N-Pulse/Transradial-Prosthesis-CTRL-HW/README.md

# Transradial Prosthesis Control Board

This work is licensed under a <a rel="license" href="https://creativecommons.org/licenses/by/4.0/">Creative Commons Attribution 4.0 International License</a>.
