N-Pulse/Transradial-Prosthesis-CTRL-HW/NPulse_v4/image-1.png

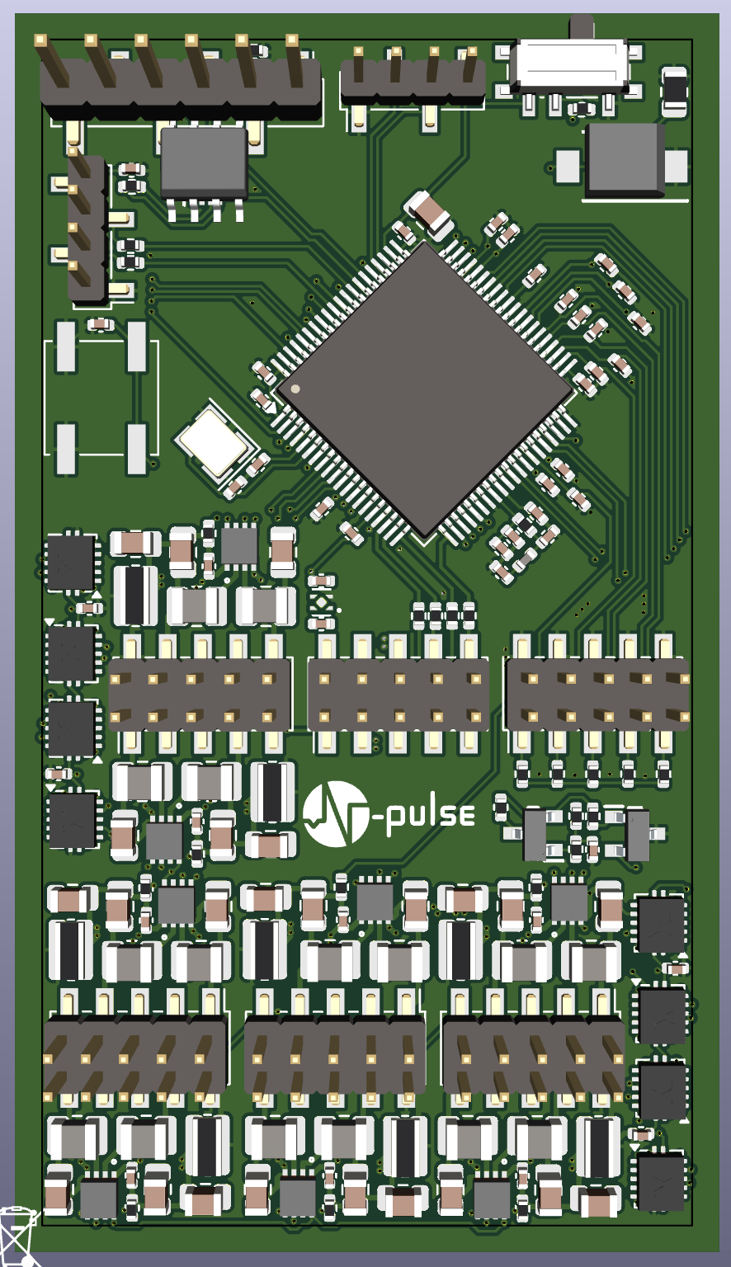
NPulse_v4/image-1.png
