N-Pulse/Transradial-Prosthesis-CTRL-HW/Report/figures/architecture.png

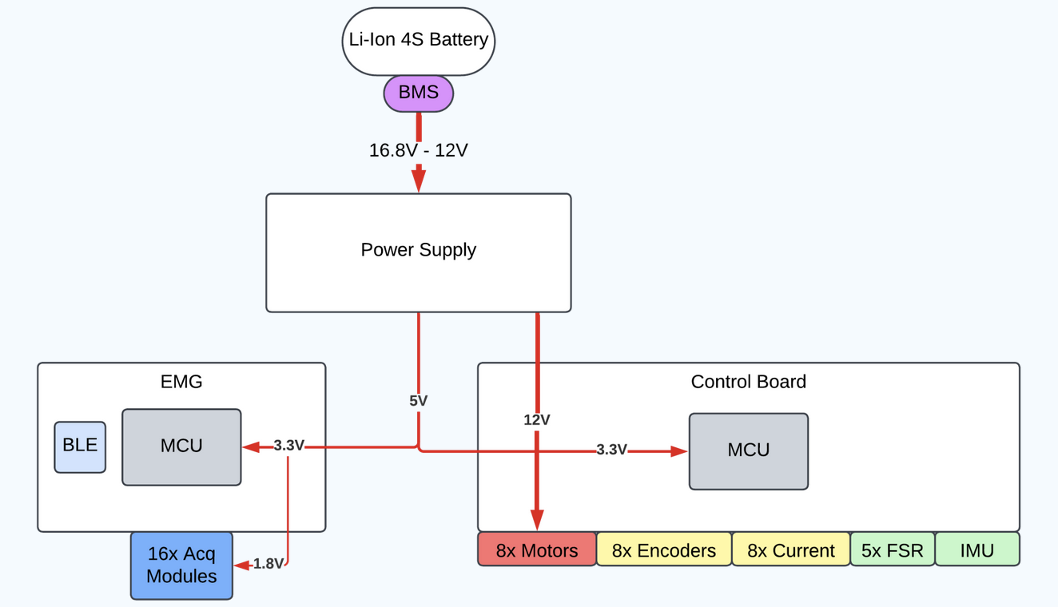
Report/figures/architecture.png
