N-Pulse/Transradial-Prosthesis-CTRL-HW/components/DRV8220DSGR/DSG0008A.stp

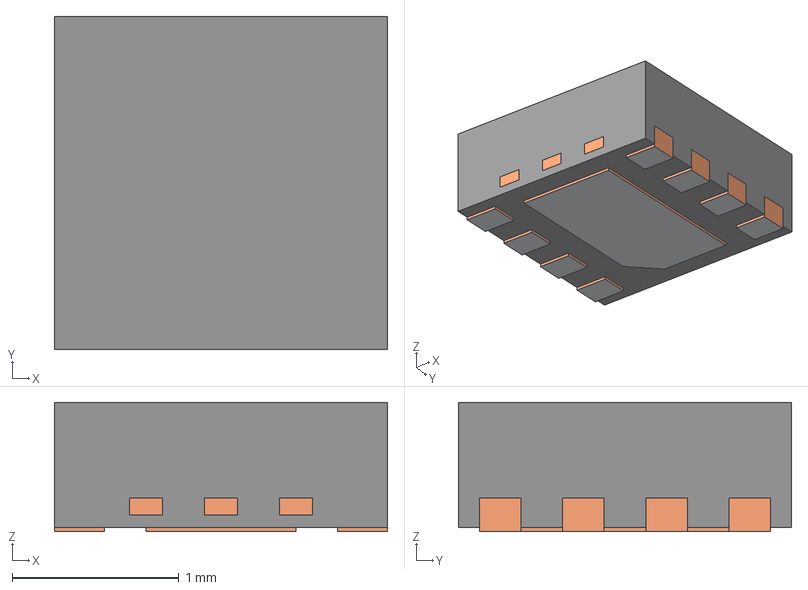
[picture p3: CAD file, 2025-02-24]
components/DRV8220DSGR/DSG0008A.stp
2.00 x 2.00 x 0.775 mm
BODY-SON
FRAME-DSG0008A
PIN1-ID
