N-Pulse/Transradial-Prosthesis-CTRL-HW/components/LIB_74HC14BQ-Q100,115/74HC14BQ-Q100,115/3D/74HC14BQ-Q100,115.stp

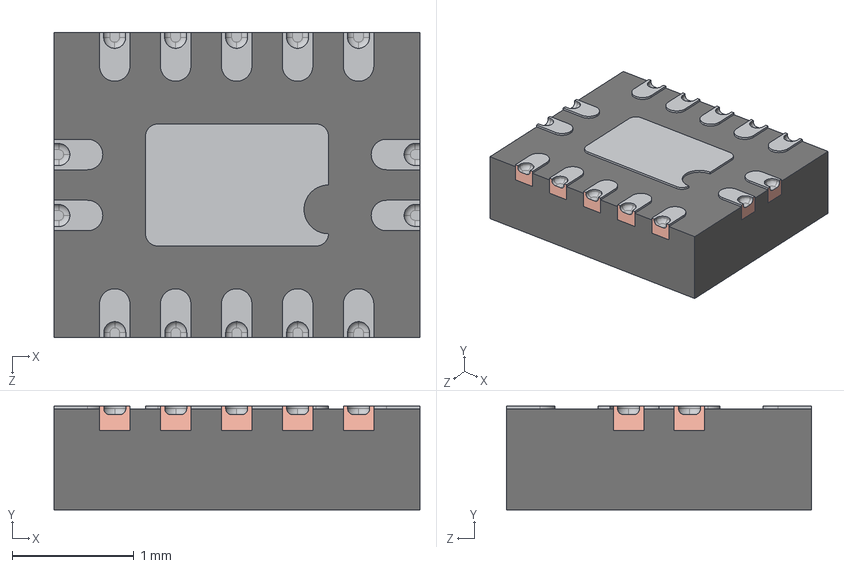
[picture p4: CAD file, 2025-02-24]
components/LIB_74HC14BQ-Q100,115/74HC14BQ-Q100,115/3D/74HC14BQ-Q100,115.stp
3.00 x 0.85 x 2.50 mm
SOT762 Body
SOT762 Heatsink
SOT762 Lead x 14
