N-Pulse/Transradial-Prosthesis-CTRL-HW/components/LIB_BSS138/BSS138/3D/BSS138.step

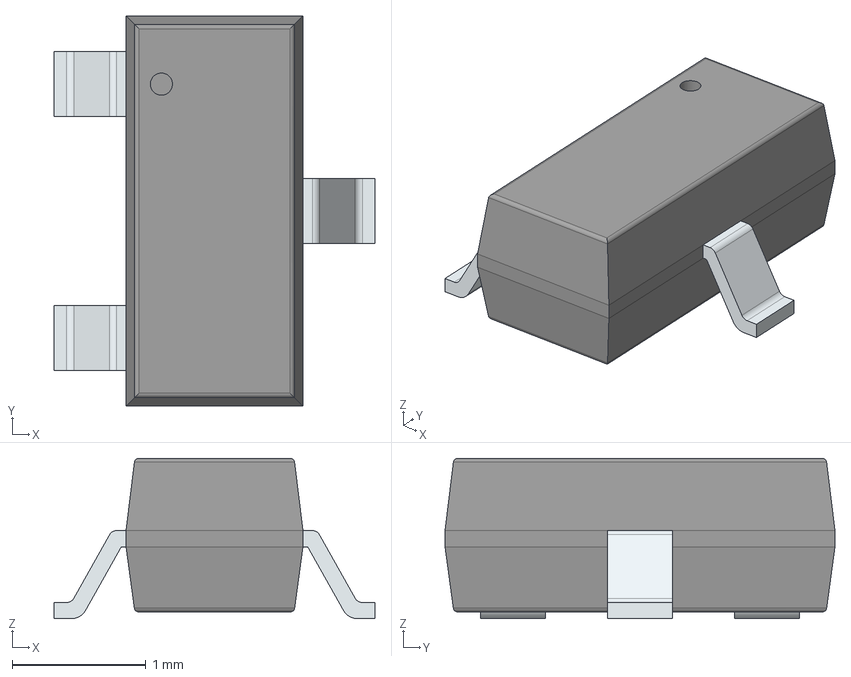
[picture p5: CAD file, 2025-02-24]
components/LIB_BSS138/BSS138/3D/BSS138.step
2.40 x 2.92 x 1.20 mm
PinsArrayL
FilletPinR
