N-Pulse/Transradial-Prosthesis-CTRL-HW/components/LIB_LQH5BPB100MT0L/LQH5BPB100MT0L/3D/LQH5BPB100MT0L.step

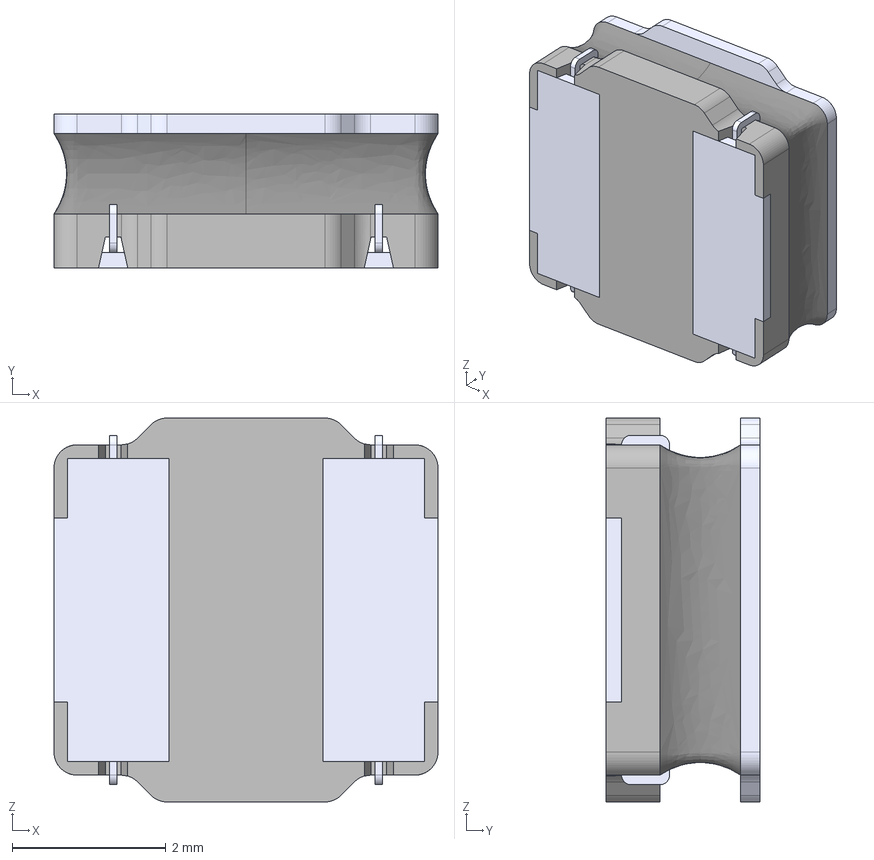
[picture p6: CAD file, 2025-02-24]
components/LIB_LQH5BPB100MT0L/LQH5BPB100MT0L/3D/LQH5BPB100MT0L.step
5.00 x 2.00 x 5.00 mm
