N-Pulse/Transradial-Prosthesis-CTRL-HW/components/LIB_QSB34CGR/QSB34CGR/3D/QSB34CGR.step

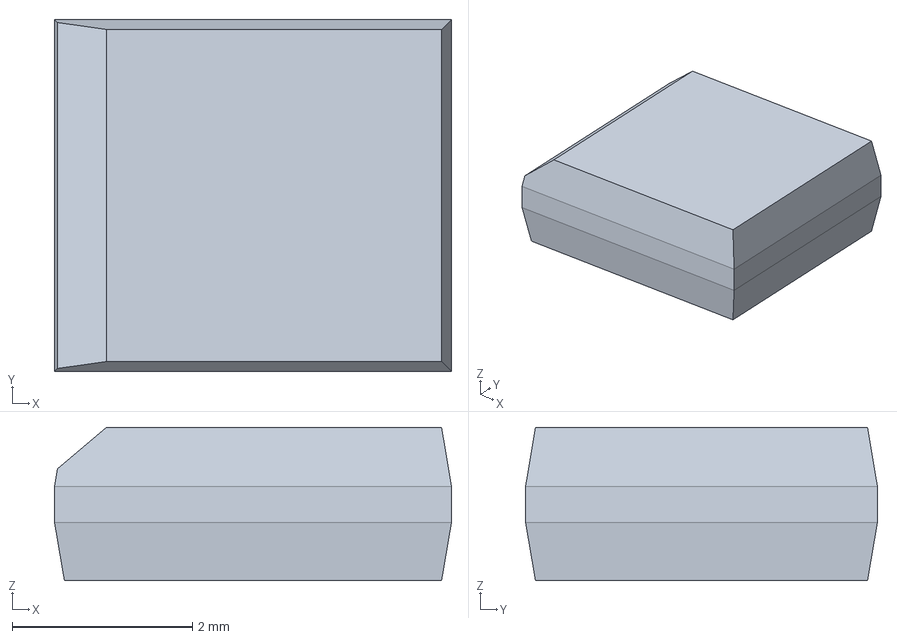
[picture p7: CAD file, 2025-02-24]
components/LIB_QSB34CGR/QSB34CGR/3D/QSB34CGR.step
4.40 x 3.90 x 1.70 mm
