N-Pulse/Transradial-Prosthesis-CTRL-HW/components/LIB_STM32G484MET6/STM32G484MET6/3D/STM32G484MET6.stp

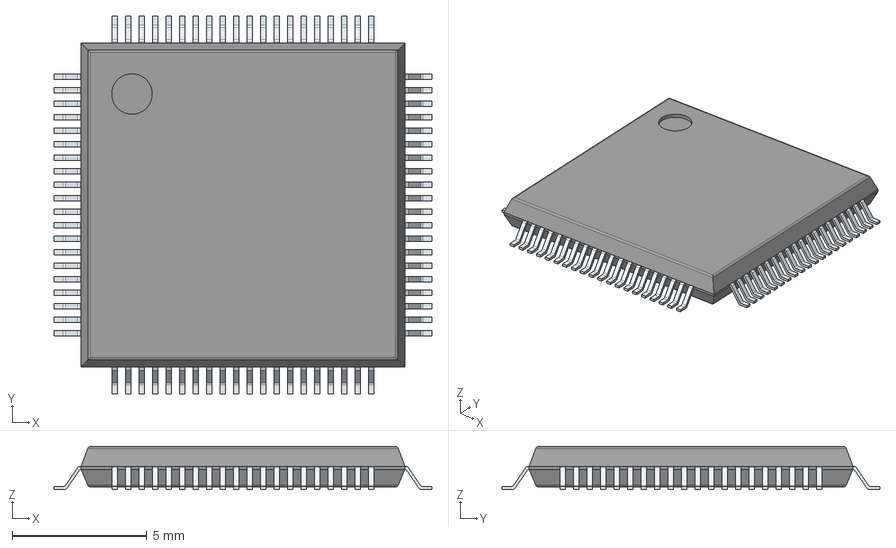
[picture p8: CAD file, 2025-02-24]
components/LIB_STM32G484MET6/STM32G484MET6/3D/STM32G484MET6.stp
14.0 x 14.0 x 1.60 mm
PinsArrayLR
PinsArrayTB
