N-Pulse/Transradial-Prosthesis-CTRL-HW/components/LIB_TL3305BF100QG/TL3305BF100QG/3D/TL3305BF100QG.step

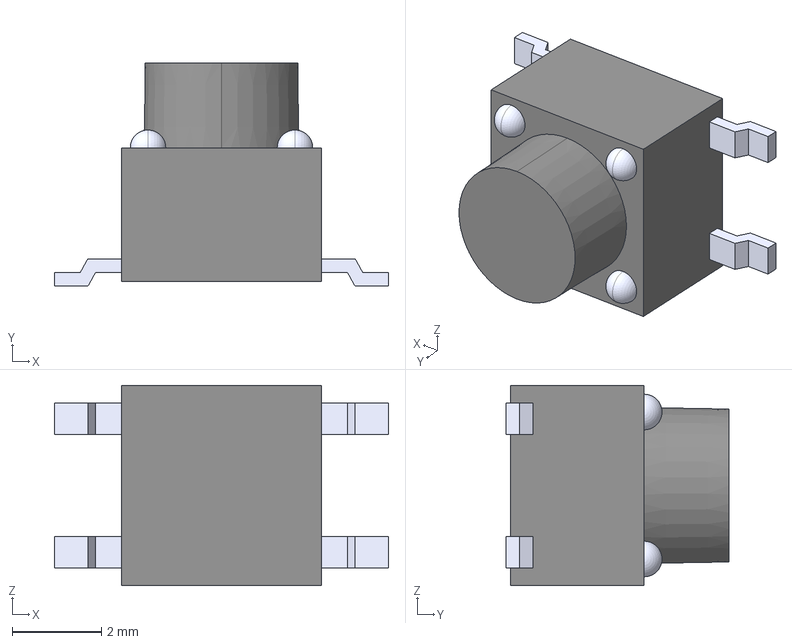
[picture p9: CAD file, 2025-02-26]
components/LIB_TL3305BF100QG/TL3305BF100QG/3D/TL3305BF100QG.step
7.50 x 5.00 x 4.50 mm
