N-Pulse/Transradial-Prosthesis-CTRL-HW/components/LIB_TXU0202DCUR 2/TXU0202DCUR/3D/TXU0202DCUR.step

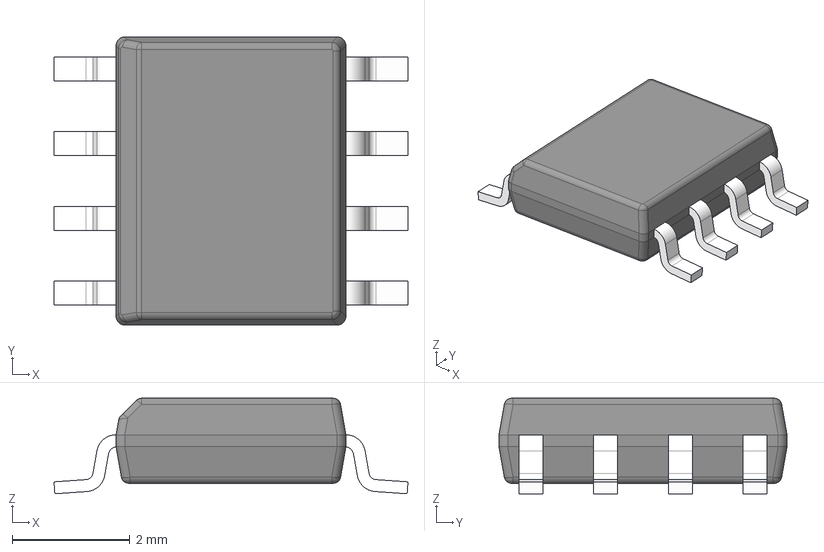
[picture p10: CAD file, 2025-02-24]
components/LIB_TXU0202DCUR 2/TXU0202DCUR/3D/TXU0202DCUR.step
6.02 x 4.90 x 1.63 mm
BODY-SO
LEAD-D0008A x 8
