N-Pulse/Transradial-Prosthesis-CTRL-HW/components/ul_TXU0202DCUR/DCU0008A.stp

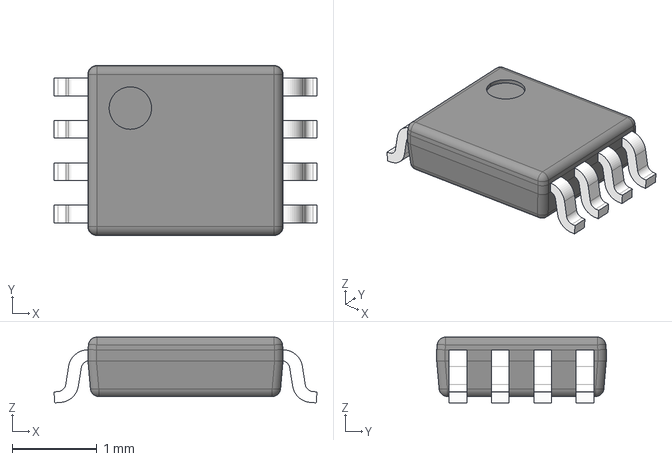
[picture p11: CAD file, 2025-02-26]
components/ul_TXU0202DCUR/DCU0008A.stp
3.10 x 2.00 x 0.775 mm
BODY-VSSOP
LEAD-VSSOP x 8
