N-Pulse/Transradial-Prosthesis-CTRL-HW/NPulse_v4/connecteur/connecteur.step

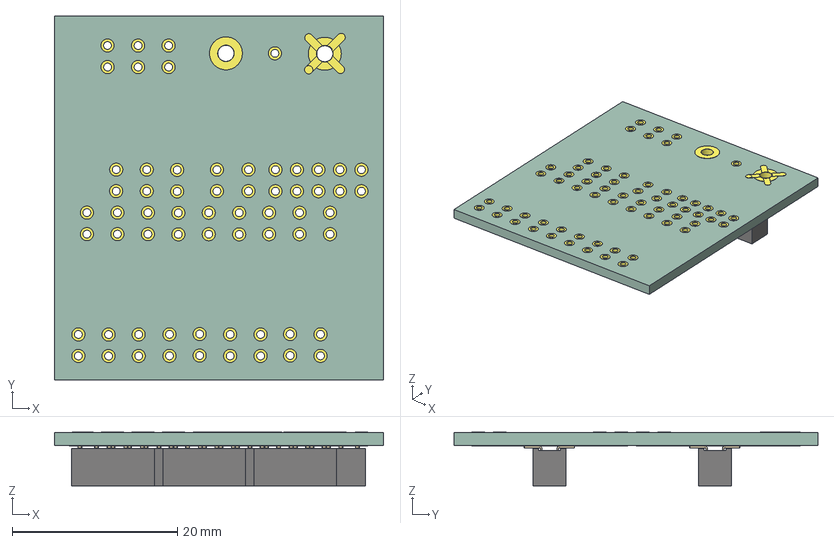
[picture p12: CAD file, 2025-02-24]
NPulse_v4/connecteur/connecteur.step
39.8 x 44.0 x 6.49 mm
PinSocket_2x05_P200mm_Vertical_SMD x 6
connecteur_track_1
connecteur_track_2
connecteur_track_3
connecteur_track_4
connecteur_track_5
connecteur_track_6
connecteur_track_7
connecteur_track_8
connecteur_track_9
connecteur_track_10
connecteur_track_11
connecteur_track_12
connecteur_track_13
connecteur_track_14
connecteur_track_15
connecteur_track_16
connecteur_track_17
connecteur_track_18
connecteur_track_19
connecteur_track_20
connecteur_track_21
connecteur_track_22
connecteur_track_23
connecteur_track_24
connecteur_track_25
connecteur_track_26
connecteur_track_27
connecteur_track_28
connecteur_track_29
connecteur_track_30
connecteur_track_31
connecteur_track_32
connecteur_track_33
connecteur_track_34
connecteur_track_35
connecteur_track_36
connecteur_track_37
connecteur_track_38
connecteur_track_39
connecteur_track_40
connecteur_track_41
connecteur_track_42
connecteur_track_43
connecteur_track_44
connecteur_track_45
connecteur_track_46
connecteur_track_47
connecteur_track_48
connecteur_track_49
connecteur_track_50
connecteur_track_51
connecteur_track_52
connecteur_track_53
connecteur_track_54
connecteur_track_55
connecteur_track_56
connecteur_track_57
connecteur_track_58
connecteur_track_59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
