N-Pulse/Transradial-Prosthesis-CTRL-HW/(list of files, cad)

Other CAD files:
components/LIB_74LVC02ABQ,115/74LVC02ABQ,115/3D/74LVC02ABQ,115.step
components/LIB_74LVC02ABQ,115/74LVC02ABQ,115/KiCad/74LVC02ABQ_115.step
components/LIB_BSS84/BSS84/3D/BSS84.step
components/LIB_BSS84/BSS84/KiCad/BSS84.step
components/LIB_DRV8220DSGR/DRV8220DSGR/3D/DRV8220DSGR.step
components/LIB_1725737/1725737/3D/1725737.step
components/LIB_1725737/1725737/3D/1725737.stp
components/LIB_1725737/1725737/Allegro/1725737.psm
components/LIB_1725737/1725737/DEHDL/1725737/chips/chips.prt
components/LIB_1725737/1725737/KiCad/1725737.step
components/LIB_1725737/1725737/KiCad/1725737.stp
components/LIB_1725753/1725753/3D/1725753.step
components/LIB_1725753/1725753/3D/1725753.stp
components/LIB_1725753/1725753/Allegro/1725753.psm
components/LIB_1725753/1725753/DEHDL/1725753/chips/chips.prt
components/LIB_1725753/1725753/KiCad/1725753.step
components/LIB_1725753/1725753/KiCad/1725753.stp
components/LIB_1985221/1985221/3D/1985221.step
components/LIB_1985221/1985221/3D/1985221.stp
components/LIB_1985221/1985221/DEHDL/1985221/chips/chips.prt
components/LIB_1985234/1985234/3D/1985234.step
components/LIB_1985234/1985234/3D/1985234.stp
components/LIB_1985234/1985234/DEHDL/1985234/chips/chips.prt
components/LIB_74HC14BQ-Q100,115/74HC14BQ-Q100,115/Allegro/74hc14bqq100115.psm
components/LIB_74HC14BQ-Q100,115/74HC14BQ-Q100,115/DEHDL/74hc14bq_q100_115/chips/chips.prt
components/LIB_74LVC02ABQ,115/74LVC02ABQ,115/Allegro/74lvc02abq115.psm
components/LIB_74LVC02ABQ,115/74LVC02ABQ,115/DEHDL/74lvc02abq_115/chips/chips.prt
components/LIB_BSS138/BSS138/3D/BSS138.stp
components/LIB_BSS138/BSS138/Allegro/sot95p240x120-3n.psm
components/LIB_BSS138/BSS138/DEHDL/bss138/chips/chips.prt
components/LIB_BSS138/BSS138/KiCad/BSS138.stp
components/LIB_BSS84/BSS84/3D/BSS84.stp
components/LIB_BSS84/BSS84/Allegro/sot95p240x120-3n.psm
components/LIB_BSS84/BSS84/DEHDL/bss84/chips/chips.prt
components/LIB_BSS84/BSS84/KiCad/BSS84.stp
components/LIB_DRV8220DSGR/DRV8220DSGR/Allegro/son50p200x200x80-9n.psm
components/LIB_DRV8220DSGR/DRV8220DSGR/DEHDL/drv8220dsgr/chips/chips.prt
components/LIB_LQH5BPB100MT0L/LQH5BPB100MT0L/3D/LQH5BPB100MT0L.stp
components/LIB_LQH5BPB100MT0L/LQH5BPB100MT0L/Allegro/lqh5bpb100mt0l.psm
components/LIB_LQH5BPB100MT0L/LQH5BPB100MT0L/DEHDL/lqh5bpb100mt0l/chips/chips.prt
components/LIB_LQH5BPB100MT0L/LQH5BPB100MT0L/KiCad/LQH5BPB100MT0L.stp
components/LIB_QSB34CGR/QSB34CGR/3D/QSB34CGR.stp
components/LIB_QSB34CGR/QSB34CGR/Allegro/sod6439x180n.psm
components/LIB_QSB34CGR/QSB34CGR/DEHDL/qsb34cgr/chips/chips.prt
components/LIB_QSB34CGR/QSB34CGR/KiCad/QSB34CGR.stp
components/LIB_STM32G484MET6/STM32G484MET6/Allegro/qfp50p1400x1400x160-80n.psm
components/LIB_STM32G484MET6/STM32G484MET6/DEHDL/stm32g484met6/chips/chips.prt
components/LIB_TL3305BF100QG/TL3305BF100QG/3D/TL3305BF100QG.stp
components/LIB_TL3305BF100QG/TL3305BF100QG/Allegro/tl3305bf160qg.psm
components/LIB_TL3305BF100QG/TL3305BF100QG/DEHDL/tl3305bf100qg/chips/chips.prt
components/LIB_TXU0202DCUR 2/TXU0202DCUR/3D/TXU0202DCUR.stp
components/LIB_TXU0202DCUR 2/TXU0202DCUR/Allegro/sop50p310x90-8n.psm
components/LIB_TXU0202DCUR 2/TXU0202DCUR/DEHDL/txu0202dcur/chips/chips.prt
