N-Pulse/Transradial-Prosthesis-CTRL-HW/(list of files, drawings)

Other design files:
components/LIB_74HC14BQ-Q100,115/74HC14BQ-Q100,115/Altium/74HC14BQ-Q100_115.SchLib
components/LIB_74HC14BQ-Q100,115/74HC14BQ-Q100,115/Altium/74HC14BQQ100115.PcbLib
components/LIB_74LVC02ABQ,115/74LVC02ABQ,115/Altium/74LVC02ABQ115.PcbLib
components/LIB_74LVC02ABQ,115/74LVC02ABQ,115/Altium/74LVC02ABQ_115.SchLib
components/LIB_1725737/1725737/Altium/1725737.PcbLib
components/LIB_1725737/1725737/Altium/1725737.SchLib
components/LIB_1725753/1725753/Altium/1725753.PcbLib
components/LIB_1725753/1725753/Altium/1725753.SchLib
components/LIB_1985221/1985221/Altium/1985221.PcbLib
components/LIB_1985221/1985221/Altium/1985221.SchLib
components/LIB_1985234/1985234/Altium/1985234.PcbLib
components/LIB_1985234/1985234/Altium/1985234.SchLib
components/LIB_BSS84/BSS84/Altium/BSS84.SchLib
components/LIB_BSS84/BSS84/Altium/SOT95P240X120-3N.PcbLib
components/LIB_BSS138/BSS138/Altium/BSS138.SchLib
components/LIB_BSS138/BSS138/Altium/SOT95P240X120-3N.PcbLib
components/LIB_DRV8220DSGR/DRV8220DSGR/Altium/DRV8220DSGR.SchLib
components/LIB_DRV8220DSGR/DRV8220DSGR/Altium/SON50P200X200X80-9N.PcbLib
components/LIB_LQH5BPB100MT0L/LQH5BPB100MT0L/Altium/LQH5BPB100MT0L.PcbLib
components/LIB_LQH5BPB100MT0L/LQH5BPB100MT0L/Altium/LQH5BPB100MT0L.SchLib
components/LIB_QSB34CGR/QSB34CGR/Altium/QSB34CGR.SchLib
components/LIB_QSB34CGR/QSB34CGR/Altium/SOD6439X180N.PcbLib
components/LIB_STM32G484MET6/STM32G484MET6/Altium/QFP50P1400X1400X160-80N.PcbLib
components/LIB_STM32G484MET6/STM32G484MET6/Altium/STM32G484MET6.SchLib
components/LIB_TXU0202DCUR/TXU0202DCUR/Altium/SOP50P310X90-8N.PcbLib
components/LIB_TXU0202DCUR/TXU0202DCUR/Altium/TXU0202DCUR.SchLib
