N-Pulse/Transradial-Prosthesis-CTRL-HW/NPulse_v4/connecteur/connecteur.kicad_pcb

## KiCad design NPulse_v4/connecteur/connecteur.kicad_pcb (2025-03-10)

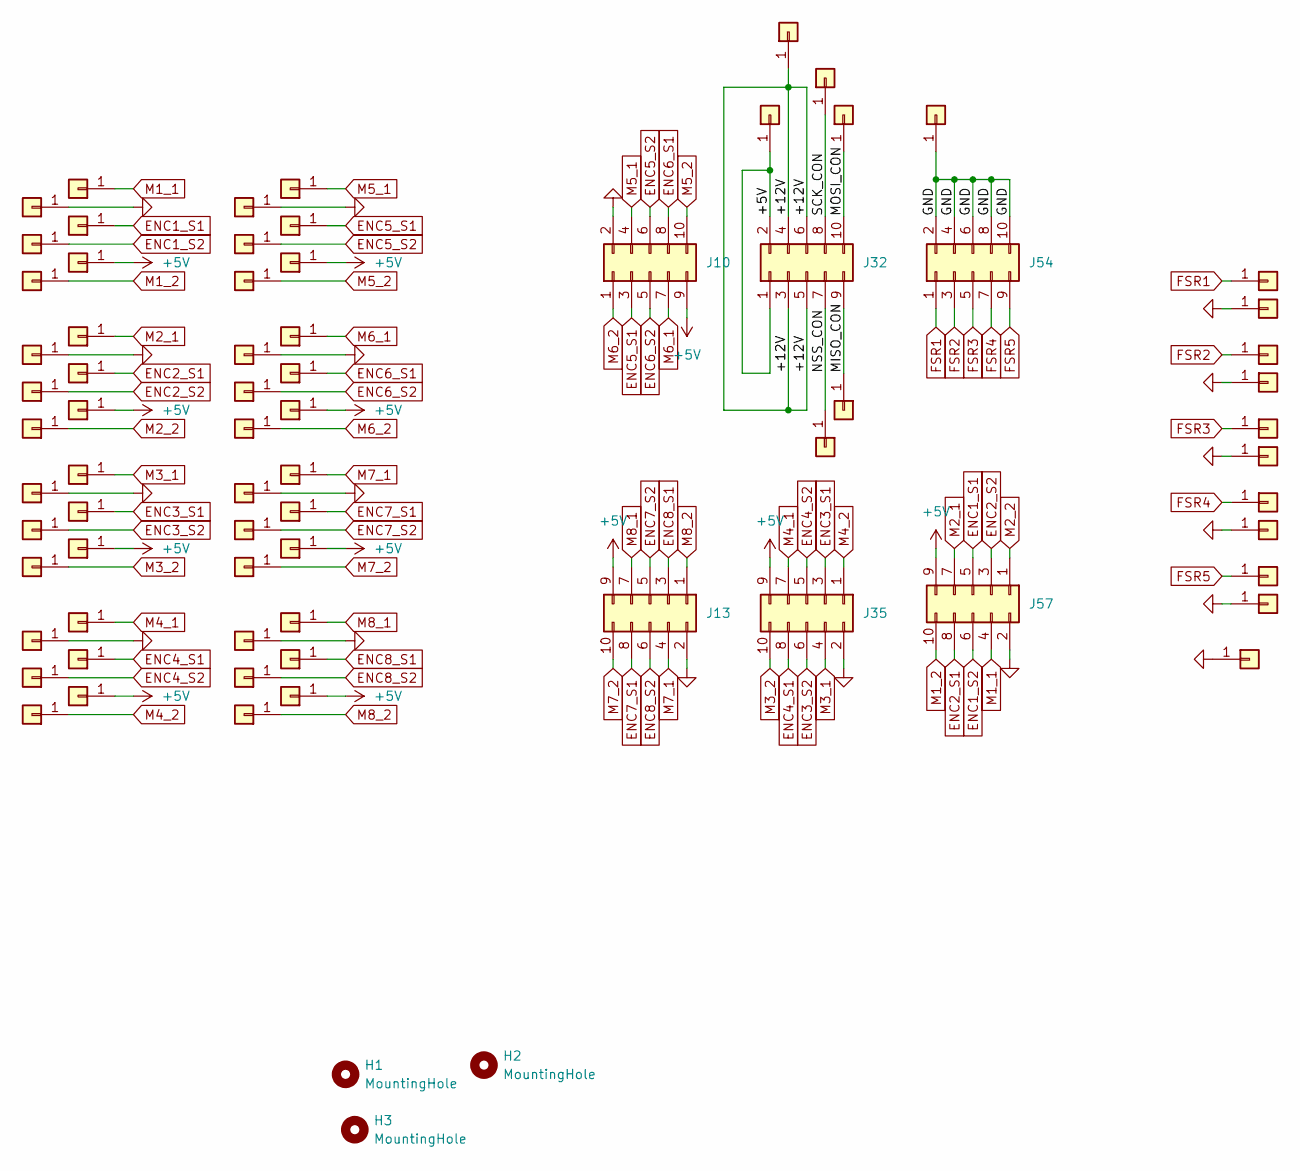
[picture p13: schematic connecteur.kicad_sch]

Parts:
H1, H2, H3: MountingHole; MountingHole_2.2mm_M2
J1, J2, J3, J4, J5, J6, J7, J8, J9, J11, J12, J14, J15, J16, J17, J18, J19, J20, J21, J22, J23, J25, J26, J27, J29, J30, J34, J36, J37, J38, J39, J40, J41, J42, J43, J44, J45, J46, J47, J48, J49, J50, J51, J52, J53, J55, J56, J58, J59, J60, J61, J62, J63, J64, J65, J66, J67, J68, J69, J70, J72, J73, J74, J75, J76, J77: Conn_01x01; SolderWire-0.1sqmm_1x01_D0.4mm_OD1mm
J10, J13, J32, J35, J54, J57: Conn_02x05_Odd_Even; PinSocket_2x05_P2.00mm_Vertical_SMD

Connections:
+5V: J6.1, J10.9, J13.9, J14.1, J20.1, J23.1, J30.1, J32.1, J32.2, J35.9, J44.1, J53.1, J57.9, J63.1, J70.1
/+12V: J27.1, J32.3, J32.4, J32.5, J32.6
/MISO_CON: J32.9, J42.1
/MOSI_CON: J32.10, J41.1
/NSS_CON: J32.7, J38.1
/SCK_CON: J32.8, J37.1
ENC1_S1: J4.1, J57.5
ENC1_S2: J3.1, J57.6
ENC2_S1: J12.1, J57.8
ENC2_S2: J8.1, J57.3
ENC3_S1: J19.1, J35.3
ENC3_S2: J16.1, J35.6
ENC4_S1: J29.1, J35.8
ENC4_S2: J22.1, J35.5
ENC5_S1: J10.3, J43.1
ENC5_S2: J10.6, J36.1
ENC6_S1: J10.8, J52.1
ENC6_S2: J10.5, J48.1
ENC7_S1: J13.8, J62.1
ENC7_S2: J13.5, J58.1
ENC8_S1: J13.3, J69.1
ENC8_S2: J13.6, J66.1
FSR1: J54.1, J72.1
FSR2: J46.1, J54.3
FSR3: J54.5, J55.1
FSR4: J54.7, J64.1
FSR5: J54.9, J75.1
GND: J2.1, J7.1, J10.2, J13.2, J15.1, J21.1, J34.1, J35.2, J45.1, J47.1, J50.1, J54.2, J54.4, J54.6, J54.8, J54.10, J56.1, J57.2, J60.1, J65.1, J73.1, J74.1, J76.1, J77.1
M1_1: J1.1, J57.4
M1_2: J5.1, J57.10
M2_1: J11.1, J57.7
M2_2: J9.1, J57.1
M3_1: J18.1, J35.4
M3_2: J17.1, J35.10
M4_1: J26.1, J35.7
M4_2: J25.1, J35.1
M5_1: J10.4, J40.1
M5_2: J10.10, J39.1
M6_1: J10.7, J51.1
M6_2: J10.1, J49.1
M7_1: J13.4, J61.1
M7_2: J13.10, J59.1
M8_1: J13.7, J68.1
M8_2: J13.1, J67.1

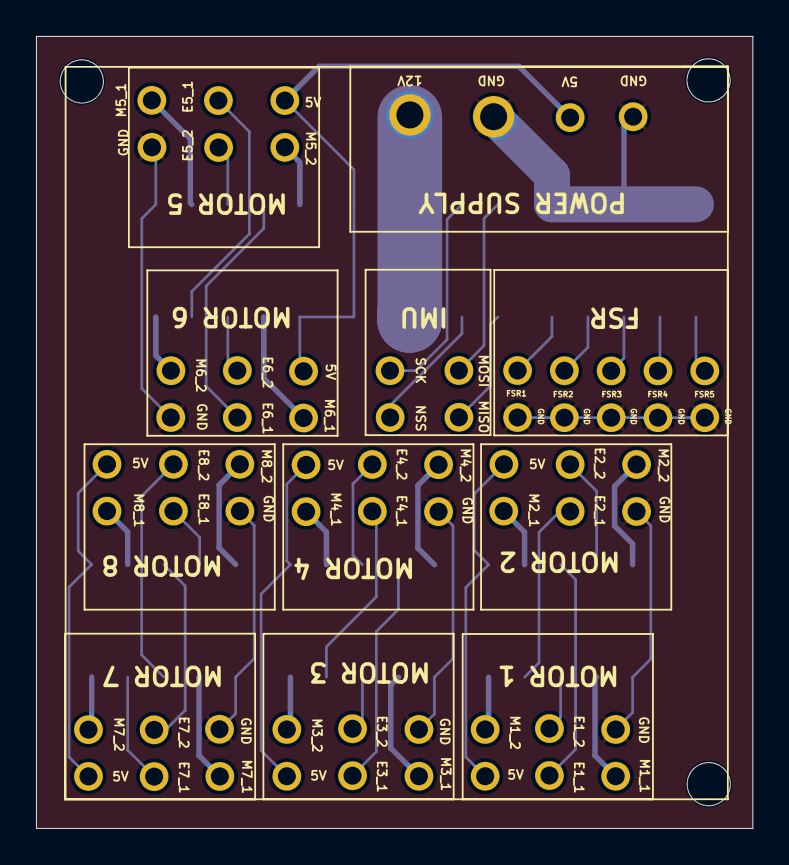
[picture p14: board connecteur.kicad_pcb from above]

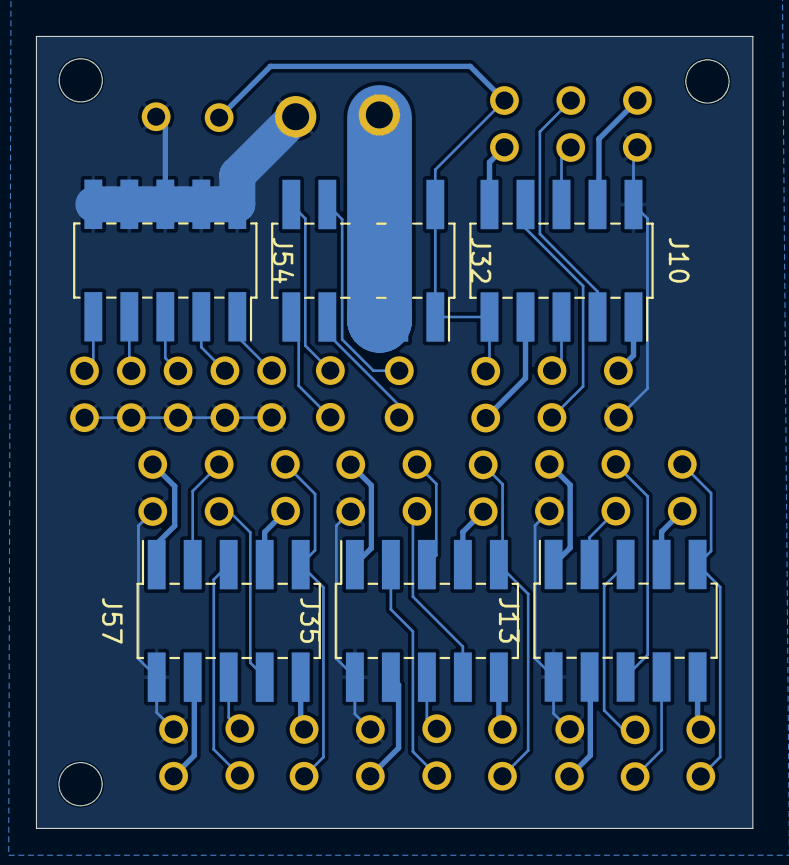
[picture p15: board connecteur.kicad_pcb from below]

Board: 4 copper layers, 39.8 x 44.0 mm, 75 parts (6 on the bottom side), 44 nets.
