N-Pulse/Transradial-Prosthesis-CTRL-HW/NPulse_v4/NPulse_v4.kicad_pcb

## KiCad design NPulse_v4/NPulse_v4.kicad_pcb (2025-03-10)

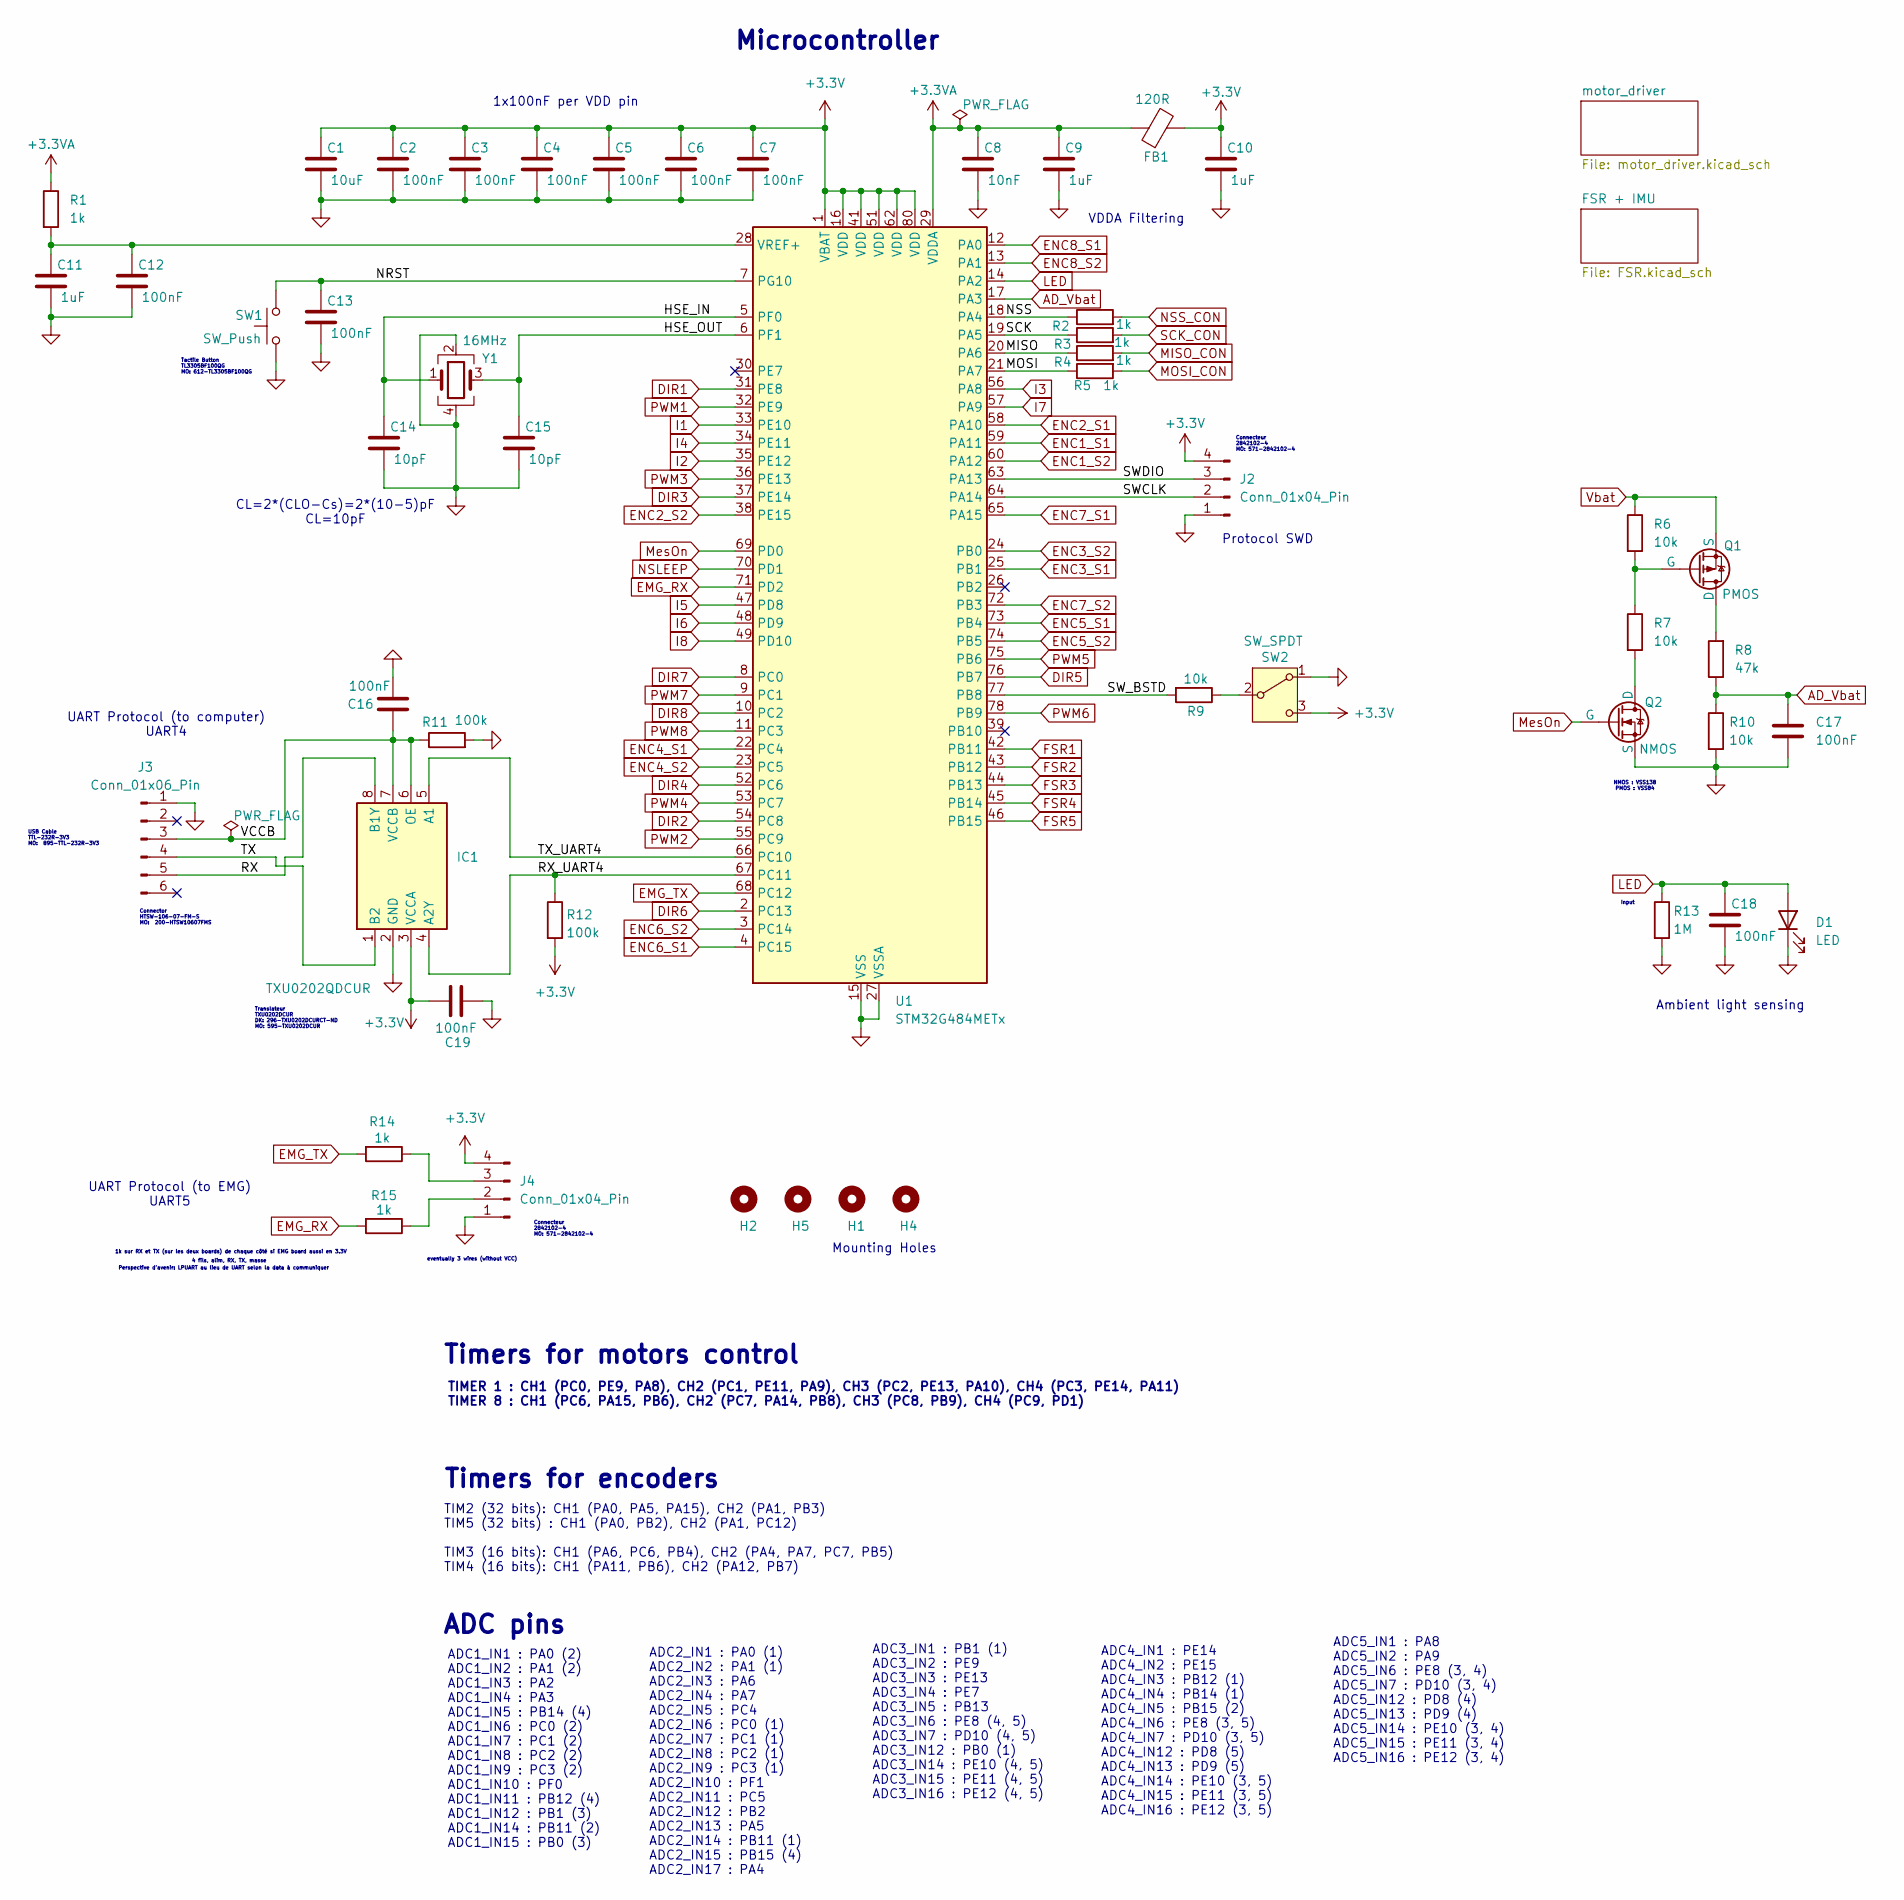
[picture p16: schematic NPulse_v4.kicad_sch]

Parts:
C1: 10uF; C_0805_2012Metric
C2, C3, C4, C5, C6, C7, C12, C13, C16, C17, C18, C19: 100nF; C_0402_1005Metric
C8: 10nF; C_0402_1005Metric
C9, C10, C11: 1uF; C_0402_1005Metric
C14, C15: 10pF; C_0402_1005Metric
D1: LED; SOD6439X180N
FB1: 120R; L_0402_1005Metric
H1, H2, H4, H5: MountingHole; MountingHole_2.2mm_M2
IC1: TXU0202QDCUR; SOP50P310X90-8N; Mouser Part Number 595-TXU0202QDCURQ1
J2, J4: Conn_01x04_Pin; PinHeader_1x04_P2.00mm_Vertical_SMD_Pin1Left
J3: Conn_01x06_Pin; PinHeader_1x06_P2.54mm_Vertical_SMD_Pin1Left
Q1: PMOS; SOT95P240X120-3N
Q2: NMOS; SOT95P240X120-3N
R1, R2, R3, R4, R5, R14, R15: 1k; R_0402_1005Metric
R6, R7, R9, R10: 10k; R_0402_1005Metric
R8: 47k; R_0402_1005Metric
R11, R12: 100k; R_0402_1005Metric
R13: 1M; R_0805_2012Metric
SW1: SW_Push; SW_SPST_TL3305B
SW2: SW_SPDT; SW_SPDT_PCM12
U1: STM32G484METx; LQFP-80_12x12mm_P0.5mm
Y1: 16MHz; Crystal_SMD_3225-4Pin_3.2x2.5mm

Connections:
+3.3V: C1.1, C2.1, C3.1, C4.1, C5.1, C6.1, C7.1, C10.1, C19.2, FB1.2, IC1.3 (VCCA), J2.4, J4.4, R12.2, SW2.3 (C), U1.1 (VBAT), U1.16 (VDD), U1.41 (VDD), U1.51 (VDD), U1.62 (VDD), U1.80 (VDD); also elsewhere on the board
+3.3VA: C8.1, C9.1, FB1.1, R1.1, U1.29 (VDDA)
/HSE_IN: C14.1, U1.5 (PF0), Y1.1
/HSE_OUT: C15.1, U1.6 (PF1), Y1.3
/MISO: R4.1, U1.20 (PA6)
/MOSI: R5.1, U1.21 (PA7)
/NRST: C13.1, SW1.1, U1.7 (PG10)
/NSS: R2.1, U1.18 (PA4)
/RX: IC1.8 (B1Y), J3.5
/RX_UART4: IC1.4 (A2Y), R12.1, U1.67 (PC11)
/SCK: R3.1, U1.19 (PA5)
/SWCLK: J2.2, U1.64 (PA14)
/SWDIO: J2.3, U1.63 (PA13)
/SW_BSTD: R9.2, U1.77 (PB8)
/TX: IC1.1 (B2), J3.4
/TX_UART4: IC1.5 (A1), U1.66 (PC10)
/VCCB: C16.2, IC1.6 (OE), IC1.7 (VCCB), J3.3, R11.1
AD_Vbat: C17.1, R8.1, R10.1, U1.17 (PA3)
DIR1: U1.31 (PE8); also elsewhere on the board
DIR2: U1.54 (PC8); also elsewhere on the board
DIR3: U1.37 (PE14); also elsewhere on the board
DIR4: U1.52 (PC6); also elsewhere on the board
DIR5: U1.76 (PB7); also elsewhere on the board
DIR6: U1.2 (PC13); also elsewhere on the board
DIR7: U1.8 (PC0); also elsewhere on the board
DIR8: U1.10 (PC2); also elsewhere on the board
EMG_RX: R15.2, U1.71 (PD2)
EMG_TX: R14.2, U1.68 (PC12)
ENC1_S1: U1.59 (PA11); also elsewhere on the board
ENC1_S2: U1.60 (PA12); also elsewhere on the board
ENC2_S1: U1.58 (PA10); also elsewhere on the board
ENC2_S2: U1.38 (PE15); also elsewhere on the board
ENC3_S1: U1.25 (PB1); also elsewhere on the board
ENC3_S2: U1.24 (PB0); also elsewhere on the board
ENC4_S1: U1.22 (PC4); also elsewhere on the board
ENC4_S2: U1.23 (PC5); also elsewhere on the board
ENC5_S1: U1.73 (PB4); also elsewhere on the board
ENC5_S2: U1.74 (PB5); also elsewhere on the board
ENC6_S1: U1.4 (PC15); also elsewhere on the board
ENC6_S2: U1.3 (PC14); also elsewhere on the board
ENC7_S1: U1.65 (PA15); also elsewhere on the board
ENC7_S2: U1.72 (PB3); also elsewhere on the board
ENC8_S1: U1.12 (PA0); also elsewhere on the board
ENC8_S2: U1.13 (PA1); also elsewhere on the board
FSR1: U1.42 (PB11); also elsewhere on the board
FSR2: U1.43 (PB12); also elsewhere on the board
FSR3: U1.44 (PB13); also elsewhere on the board
FSR4: U1.45 (PB14); also elsewhere on the board
FSR5: U1.46 (PB15); also elsewhere on the board
GND: C1.2, C2.2, C3.2, C4.2, C5.2, C6.2, C7.2, C8.2, C9.2, C10.2, C11.2, C12.2, C13.2, C14.2, C15.2, C16.1, C17.2, C18.2, C19.1, D1.1 (K), IC1.2 (GND), J2.1, J3.1, J4.1, Q2.3 (S), R10.2, R11.2, R13.2, SW1.2, SW2.1 (A), U1.15 (VSS), U1.27 (VSSA), U1.40 (VSS), U1.50 (VSS), U1.61 (VSS), U1.79 (VSS), Y1.2, Y1.4; also elsewhere on the board
I1: U1.33 (PE10); also elsewhere on the board
I2: U1.35 (PE12); also elsewhere on the board
I3: U1.56 (PA8); also elsewhere on the board
I4: U1.34 (PE11); also elsewhere on the board
I5: U1.47 (PD8); also elsewhere on the board
I6: U1.48 (PD9); also elsewhere on the board
I7: U1.57 (PA9); also elsewhere on the board
I8: U1.49 (PD10); also elsewhere on the board
LED: C18.1, D1.2 (A), R13.1, U1.14 (PA2)
MISO_CON: R4.2; also elsewhere on the board
MOSI_CON: R5.2; also elsewhere on the board
MesOn: Q2.2 (G), U1.69 (PD0)
NSLEEP: U1.70 (PD1); also elsewhere on the board
NSS_CON: R2.2; also elsewhere on the board
unnamed: J4.2, R15.1
unnamed: J4.3, R14.1
unnamed: Q1.1 (D), R8.2
unnamed: Q1.2 (G), R6.2, R7.1
unnamed: Q2.1 (D), R7.2
unnamed: R9.1, SW2.2 (B)
unnamed: C11.1, C12.1, R1.2, U1.28 (VREF+)
PWM1: U1.32 (PE9); also elsewhere on the board
PWM2: U1.55 (PC9); also elsewhere on the board
PWM3: U1.36 (PE13); also elsewhere on the board
PWM4: U1.53 (PC7); also elsewhere on the board
PWM5: U1.75 (PB6); also elsewhere on the board
PWM6: U1.78 (PB9); also elsewhere on the board
PWM7: U1.9 (PC1); also elsewhere on the board
PWM8: U1.11 (PC3); also elsewhere on the board
SCK_CON: R3.2; also elsewhere on the board
Vbat: Q1.3 (S), R6.1

Notes on the sheet:
1x100nF per VDD pin
NMOS : VSS138 PMOS : VSS84
1k sur RX et TX (sur les deux boards) de chaque côté si EMG board aussi en 3.3V
UART Protocol (to computer) UART4
ADC3_IN1 : PB1 (1) ADC3_IN2 : PE9 ADC3_IN3 : PE13 ADC3_IN4 : PE7 ADC3_IN5 : PB13 ADC3_IN6 : PE8 (4, 5) ADC3_IN7 : PD10 (4, 5) ADC3_IN12 : PB0 (1) ADC3_IN14 : PE10 (4, 5) ADC3_IN15 : PE11 (4, 5) ADC3_IN16 : PE12 (4, 5)
Mounting Holes
ADC2_IN1 : PA0 (1) ADC2_IN2 : PA1 (1) ADC2_IN3 : PA6 ADC2_IN4 : PA7 ADC2_IN5 : PC4 ADC2_IN6 : PC0 (1) ADC2_IN7 : PC1 (1) ADC2_IN8 : PC2 (1) ADC2_IN9 : PC3 (1) ADC2_IN10 : PF1 ADC2_IN11 : PC5 ADC2_IN12 : PB2 ADC2_IN13 : PA5 ADC2_IN14 : PB11 (1) ADC2_IN15 : PB15 (4) ADC2_IN17 : PA4
USB Cable TTL-232R-3V3 MO: 895-TTL-232R-3V3
Timers for motors control
ADC4_IN1 : PE14 ADC4_IN2 : PE15 ADC4_IN3 : PB12 (1) ADC4_IN4 : PB14 (1) ADC4_IN5 : PB15 (2) ADC4_IN6 : PE8 (3, 5) ADC4_IN7 : PD10 (3, 5) ADC4_IN12 : PD8 (5) ADC4_IN13 : PD9 (5) ADC4_IN14 : PE10 (3, 5) ADC4_IN15 : PE11 (3, 5) ADC4_IN16 : PE12 (3, 5)
Translateur TXU0202DCUR DK: 296-TXU0202DCURCT-ND MO: 595-TXU0202DCUR
TIM2 (32 bits): CH1 (PA0, PA5, PA15), CH2 (PA1, PB3) TIM5 (32 bits) : CH1 (PA0, PB2), CH2 (PA1, PC12) TIM3 (16 bits): CH1 (PA6, PC6, PB4), CH2 (PA4, PA7, PC7, PB5) TIM4 (16 bits): CH1 (PA11, PB6), CH2 (PA12, PB7)
VDDA Filtering
ADC1_IN1 : PA0 (2) ADC1_IN2 : PA1 (2) ADC1_IN3 : PA2 ADC1_IN4 : PA3 ADC1_IN5 : PB14 (4) ADC1_IN6 : PC0 (2) ADC1_IN7 : PC1 (2) ADC1_IN8 : PC2 (2) ADC1_IN9 : PC3 (2) ADC1_IN10 : PF0 ADC1_IN11 : PB12 (4) ADC1_IN12 : PB1 (3) ADC1_IN14 : PB11 (2) ADC1_IN15 : PB0 (3)
Connecteur 2842102-4 MO: 571-2842102-4
eventually 3 wires (without VCC)
TIMER 1 : CH1 (PC0, PE9, PA8), CH2 (PC1, PE11, PA9), CH3 (PC2, PE13, PA10), CH4 (PC3, PE14, PA11) TIMER 8 : CH1 (PC6, PA15, PB6), CH2 (PC7, PA14, PB8), CH3 (PC8, PB9), CH4 (PC9, PD1)
Microcontroller
ADC5_IN1 : PA8 ADC5_IN2 : PA9 ADC5_IN6 : PE8 (3, 4) ADC5_IN7 : PD10 (3, 4) ADC5_IN12 : PD8 (4) ADC5_IN13 : PD9 (4) ADC5_IN14 : PE10 (3, 4) ADC5_IN15 : PE11 (3, 4) ADC5_IN16 : PE12 (3, 4)
CL=2*(CLO-Cs)=2*(10-5)pF CL=10pF
Tactile Button TL3305BF100QG MO: 612-TL3305BF100QG
Perspective d'avenir: LPUART au lieu de UART selon la data à communiquer
4 fils, alim, RX, TX, masse
ADC pins
UART Protocol (to EMG) UART5
Input
Timers for encoders
Ambient light sensing
Connector HTSW-106-07-FM-S MO: 200-HTSW10607FMS
Protocol SWD

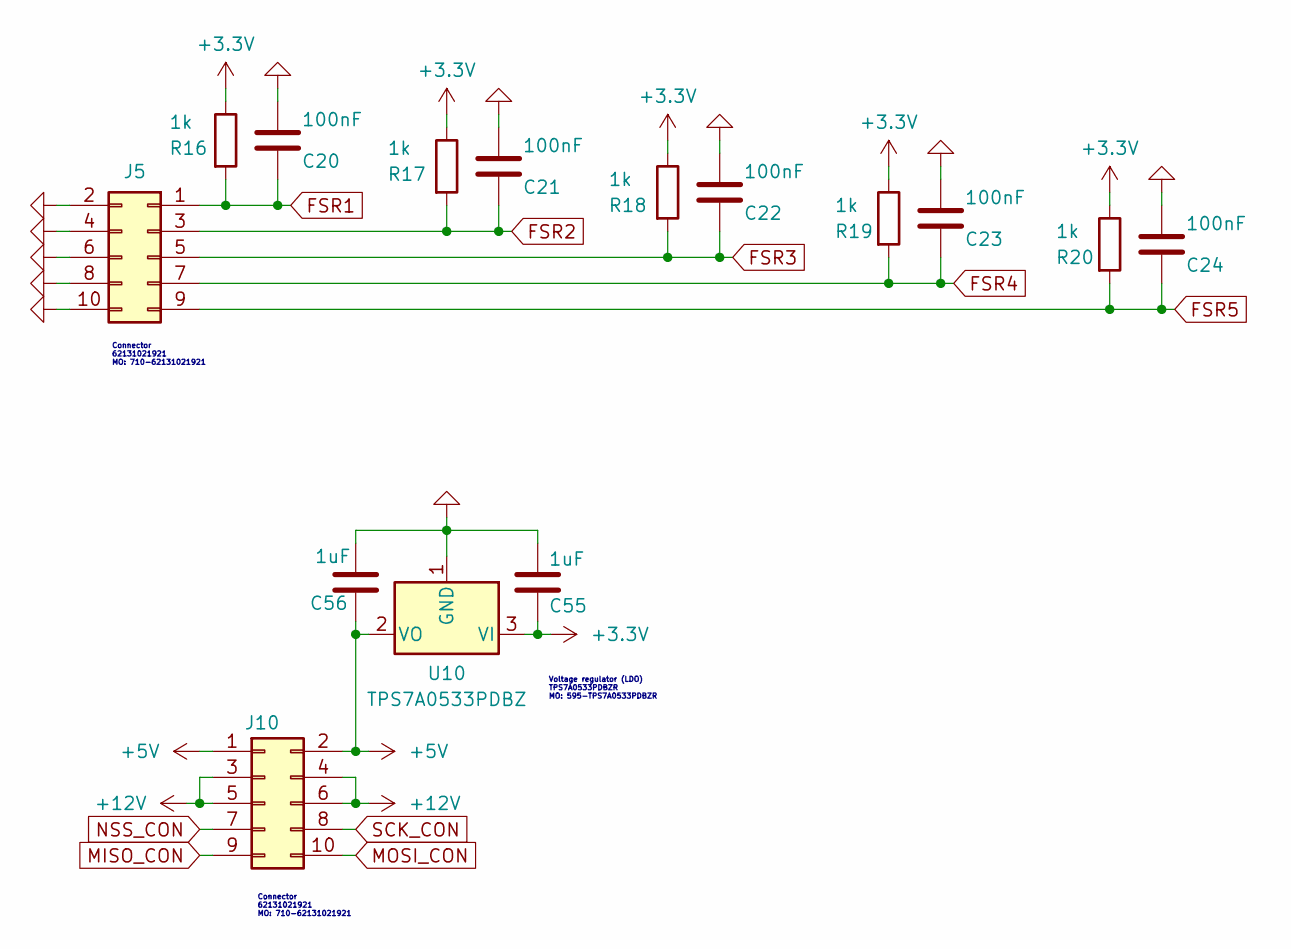
[picture p17: schematic FSR.kicad_sch]

Parts:
C20, C21, C22, C23, C24: 100nF; C_0402_1005Metric
C55, C56: 1uF; C_0402_1005Metric
J5, J10: Conn_02x05_Odd_Even; PinHeader_2x05_P2.00mm_Vertical_SMD
R16, R17, R18, R19, R20: 1k; R_0402_1005Metric
U10: TPS7A0533PDBZ; SOT-23

Connections:
+3.3V: C55.1, R16.1, R17.1, R18.1, R19.1, R20.1, U10.3 (VI); also elsewhere on the board
+5V: C56.1, J10.1, J10.2, U10.2 (VO); also elsewhere on the board
+12V: J10.3, J10.4, J10.5, J10.6; also elsewhere on the board
FSR1: C20.2, J5.1, R16.2; also elsewhere on the board
FSR2: C21.2, J5.3, R17.2; also elsewhere on the board
FSR3: C22.2, J5.5, R18.2; also elsewhere on the board
FSR4: C23.2, J5.7, R19.2; also elsewhere on the board
FSR5: C24.2, J5.9, R20.2; also elsewhere on the board
GND: C20.1, C21.1, C22.1, C23.1, C24.1, C55.2, C56.2, J5.2, J5.4, J5.6, J5.8, J5.10, U10.1 (GND); also elsewhere on the board
MISO_CON: J10.9; also elsewhere on the board
MOSI_CON: J10.10; also elsewhere on the board
NSS_CON: J10.7; also elsewhere on the board
SCK_CON: J10.8; also elsewhere on the board

Notes on the sheet:
Connector 62131021921 MO: 710-62131021921
Voltage regulator (LDO) TPS7A0533PDBZR MO: 595-TPS7A0533PDBZR

Schematic: motor_driver.kicad_sch

Parts:
C25, C27, C31, C32, C35, C36, C37, C39, C43, C44, C47, C48, C49, C51, C59, C60, C61, C63, C71, C72: 100nF; C_0402_1005Metric
C26, C28, C29, C30, C33, C34, C38, C40, C41, C42, C45, C46, C50, C52, C53, C54, C57, C58, C62, C64, C65, C66, C69, C70: 10uF; C_0805_2012Metric
IC2, IC3, IC5, IC6, IC7, IC8, IC9: DRV8220DSGR; WSON8_DSG_TEX; Mouser Part Number 595-DRV8220DSGR
IC4: DRV8220DSGR; SON50P200X200X80-9N; Mouser Part Number 595-DRV8220DSGR
J6, J7, J8, J9: Conn_02x05_Odd_Even; PinHeader_2x05_P2.00mm_Vertical_SMD
L1, L2, L3, L4, L5, L6, L7, L8, L9, L10, L11, L12, L13, L14, L15, L16: 10uH; L_1008_2520Metric
R21, R22, R25, R26, R29, R30, R33, R34: 1k; R_0402_1005Metric
R23, R24, R27, R28, R31, R32, R35, R36: 1; R_0612_1632Metric
U2, U3, U4, U5, U6, U7, U8, U9: SN74LVC002; DHVQFN-14-1EP_2.5x3mm_P0.5mm_EP1x1.5mm

Connections:
+3.3V: C31.1, C32.1, C43.1, C44.1, U2.14 (VCC), U3.14 (VCC), U4.14 (VCC), U5.14 (VCC), U6.14 (VCC), U7.14 (VCC), U8.14 (VCC), U9.14 (VCC); also elsewhere on the board
+5V: J6.9, J7.9, J8.9, J9.9; also elsewhere on the board
+12V: C25.2, C26.1, C27.2, C28.1, C37.2, C38.1, C39.2, C40.1, C49.2, C50.1, C51.2, C52.1, C61.2, C62.1, C63.2, C64.1, IC2.1 (VM), IC3.1 (VM), IC4.1 (VM), IC5.1 (VM), IC6.1 (VM), IC7.1 (VM), IC8.1 (VM), IC9.1 (VM); also elsewhere on the board
DIR1: U2.5, U2.6, U2.12; also elsewhere on the board
DIR2: U4.5, U4.6, U4.12; also elsewhere on the board
DIR3: U6.5, U6.6, U6.12; also elsewhere on the board
DIR4: U8.5, U8.6, U8.12; also elsewhere on the board
DIR5: U3.5, U3.6, U3.12; also elsewhere on the board
DIR6: U5.5, U5.6, U5.12; also elsewhere on the board
DIR7: U7.5, U7.6, U7.12; also elsewhere on the board
DIR8: U9.5, U9.6, U9.12; also elsewhere on the board
ENC1_S1: J9.5; also elsewhere on the board
ENC1_S2: J9.6; also elsewhere on the board
ENC2_S1: J9.8; also elsewhere on the board
ENC2_S2: J9.3; also elsewhere on the board
ENC3_S1: J7.3; also elsewhere on the board
ENC3_S2: J7.6; also elsewhere on the board
ENC4_S1: J7.8; also elsewhere on the board
ENC4_S2: J7.5; also elsewhere on the board
ENC5_S1: J8.3; also elsewhere on the board
ENC5_S2: J8.6; also elsewhere on the board
ENC6_S1: J8.8; also elsewhere on the board
ENC6_S2: J8.5; also elsewhere on the board
ENC7_S1: J6.8; also elsewhere on the board
ENC7_S2: J6.5; also elsewhere on the board
ENC8_S1: J6.3; also elsewhere on the board
ENC8_S2: J6.6; also elsewhere on the board
GND: C31.2, C32.2, C35.2, C36.2, C43.2, C44.2, C47.2, C48.2, C59.2, C60.2, C71.2, C72.2, J6.2, J7.2, J8.2, J9.2, R23.2, R24.2, R27.2, R28.2, R31.2, R32.2, R35.2, R36.2, U2.7 (GND), U2.15, U3.7 (GND), U3.15, U4.7 (GND), U4.15, U5.7 (GND), U5.15, U6.7 (GND), U6.15, U7.7 (GND), U7.15, U8.7 (GND), U8.15, U9.7 (GND), U9.15; also elsewhere on the board
I1: C35.1, R21.1; also elsewhere on the board
I2: C47.1, R25.1; also elsewhere on the board
I3: C59.1, R29.1; also elsewhere on the board
I4: C71.1, R33.1; also elsewhere on the board
I5: C36.1, R22.1; also elsewhere on the board
I6: C48.1, R26.1; also elsewhere on the board
I7: C60.1, R30.1; also elsewhere on the board
I8: C72.1, R34.1; also elsewhere on the board
M1_1: C29.1, J9.4, L1.2
M1_2: C33.1, J9.10, L3.2
M2_1: C41.1, J9.7, L5.2
M2_2: C45.1, J9.1, L7.2
M3_1: C53.1, J7.4, L9.2
M3_2: C57.1, J7.10, L11.2
M4_1: C65.1, J7.7, L13.2
M4_2: C69.1, J7.1, L15.2
M5_1: C30.1, J8.4, L2.2
M5_2: C34.1, J8.10, L4.2
M6_1: C42.1, J8.7, L6.2
M6_2: C46.1, J8.1, L8.2
M7_1: C54.1, J6.4, L10.2
M7_2: C58.1, J6.10, L12.2
M8_1: C66.1, J6.7, L14.2
M8_2: C70.1, J6.1, L16.2
NSLEEP: IC2.8 (NSLEEP), IC3.8 (NSLEEP), IC4.8 (NSLEEP), IC5.8 (NSLEEP), IC6.8 (NSLEEP), IC7.8 (NSLEEP), IC8.8 (NSLEEP), IC9.8 (NSLEEP); also elsewhere on the board
unnamed: IC2.2 (OUT1), L1.1
unnamed: IC2.3 (OUT2), L3.1
unnamed: IC3.2 (OUT1), L2.1
unnamed: IC3.3 (OUT2), L4.1
unnamed: IC4.2 (OUT1), L5.1
unnamed: IC4.3 (OUT2), L7.1
unnamed: IC5.2 (OUT1), L6.1
unnamed: IC5.3 (OUT2), L8.1
unnamed: IC6.2 (OUT1), L9.1
unnamed: IC6.3 (OUT2), L11.1
unnamed: IC7.2 (OUT1), L10.1
unnamed: IC7.3 (OUT2), L12.1
unnamed: IC8.2 (OUT1), L13.1
unnamed: IC8.3 (OUT2), L15.1
unnamed: IC9.2 (OUT1), L14.1
unnamed: IC9.3 (OUT2), L16.1
unnamed: U2.3, U2.4
unnamed: U2.2, U2.10, U2.11
unnamed: U3.3, U3.4
unnamed: U3.2, U3.10, U3.11
unnamed: U4.3, U4.4
unnamed: U4.2, U4.10, U4.11
unnamed: U5.3, U5.4
unnamed: U5.2, U5.10, U5.11
unnamed: U6.3, U6.4
unnamed: U6.2, U6.10, U6.11
unnamed: U7.3, U7.4
unnamed: U7.2, U7.10, U7.11
unnamed: U8.3, U8.4
unnamed: U8.2, U8.10, U8.11
unnamed: U9.3, U9.4
unnamed: U9.2, U9.10, U9.11
OUT1_1: IC2.6 (IN1/PH), U2.13
OUT1_2: IC2.5 (IN2/EN), U2.1
OUT2_1: IC4.6 (IN1/PH), U4.13
OUT2_2: IC4.5 (IN2/EN), U4.1
OUT3_1: IC6.6 (IN1/PH), U6.13
OUT3_2: IC6.5 (IN2/EN), U6.1
OUT4_1: IC8.6 (IN1/PH), U8.13
OUT4_2: IC8.5 (IN2/EN), U8.1
OUT5_1: IC3.6 (IN1/PH), U3.13
OUT5_2: IC3.5 (IN2/EN), U3.1
OUT6_1: IC5.6 (IN1/PH), U5.13
OUT6_2: IC5.5 (IN2/EN), U5.1
OUT7_1: IC7.6 (IN1/PH), U7.13
OUT7_2: IC7.5 (IN2/EN), U7.1
OUT8_1: IC9.6 (IN1/PH), U9.13
OUT8_2: IC9.5 (IN2/EN), U9.1
PWM1: U2.8, U2.9; also elsewhere on the board
PWM2: U4.8, U4.9; also elsewhere on the board
PWM3: U6.8, U6.9; also elsewhere on the board
PWM4: U8.8, U8.9; also elsewhere on the board
PWM5: U3.8, U3.9; also elsewhere on the board
PWM6: U5.8, U5.9; also elsewhere on the board
PWM7: U7.8, U7.9; also elsewhere on the board
PWM8: U9.8, U9.9; also elsewhere on the board
pin4_1: C25.1, C26.2, C29.2, C33.2, IC2.4 (GND), IC2.9, R21.2, R23.1
pin4_2: C37.1, C38.2, C41.2, C45.2, IC4.4 (GND), IC4.9, R25.2, R27.1
pin4_3: C49.1, C50.2, C53.2, C57.2, IC6.4 (GND), IC6.9, R29.2, R31.1
pin4_4: C61.1, C62.2, C65.2, C69.2, IC8.4 (GND), IC8.9, R33.2, R35.1
pin4_5: C27.1, C28.2, C30.2, C34.2, IC3.4 (GND), IC3.9, R22.2, R24.1
pin4_6: C39.1, C40.2, C42.2, C46.2, IC5.4 (GND), IC5.9, R26.2, R28.1
pin4_7: C51.1, C52.2, C54.2, C58.2, IC7.4 (GND), IC7.9, R30.2, R32.1
pin4_8: C63.1, C64.2, C66.2, C70.2, IC9.4 (GND), IC9.9, R34.2, R36.1

Notes on the sheet:
connecter à la pin 4 au lieu de la vraie masse pour éviter les rebouclages de courant
Thermal pad au terminal de la pin 4
Motor driver DRV8220DSGR MO: 595-DRV8220DSGR package: WSON
Shunt LTR18EZPFL1R00 MO: 755-LTR18EZPFL1R00
Capacitor (2 fois) GRM21BC81C106KE5K MO: 81-GRM21BC81C106KE5K
Inductance (2 fois) AOTA-B252010S100MT MO: 815-AOTB252010S100MT
grande par rapport au shunt
Connector 62131021921 MO: 710-62131021921
4 NOR-Gates (2 fois) 595-SN74LVC02ABQAR MO: 595-SN74LVC02ABQAR Package_DFN_QFN:DHVQFN-14-1EP_2.5x3mm_P0.5mm_EP1x1.5mm
Motor VCC Encoder GND Encoder Signal 1 Encoder Signal 2 Encoder VCC Motor GND
C119, C114, C115, C117 à la pin 4 pour éviter les rebouclages de courant

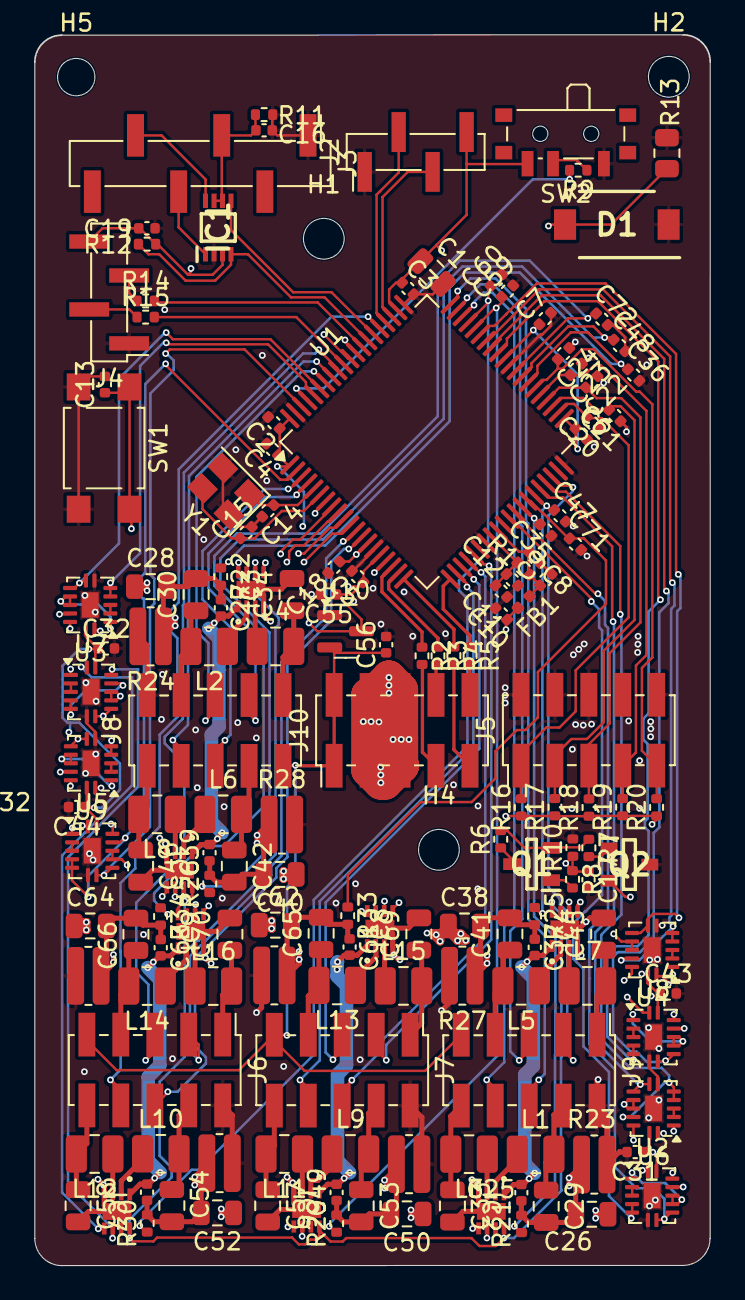
[picture p18: board NPulse_v4.kicad_pcb from above]

Board: 4 copper layers, 39.8 x 72.5 mm, 161 parts (0 on the bottom side), 155 nets.
