N-Pulse/Transradial-Prosthesis-CTRL-HW/(commit log)

2024-11-22 add my work done so far on git
    [NPulse_v2.kicad_pcb, NPulse_v2.kicad_sch, motor_driver.kicad_sch, npulse_v1.kicad_sch]
2024-12-02 Add MCU, FSR, motor drivers, light sensing
    [COM_EMG.kicad_sch, FSR.kicad_sch, NPulse_v2.kicad_sch, first_idea.kicad_sch, motor_driver.kicad_sch, motor_driver2.kicad_sch, npulse_v1.kicad_sch, test.kicad_sch]
2024-12-08 Version 3 - motor driver updated, FSR updated
    [FSR.kicad_sch, NPulse_v2.kicad_sch, NPulse_v3.kicad_pcb, NPulse_v3.kicad_sch, motor_driver.kicad_sch, motor_driver2.kicad_sch, pyvenv.cfg, test.kicad_sch]
2025-02-24 Version 4
    [1725737.PcbLib, 1725737.SchLib, 1725737.psm, 1725737.step, 1725737.stp, 1725753.PcbLib, 1725753.SchLib, 1725753.psm]
2025-02-26 some modifications on the routing
    [DCU0008A.stp, EDI2CAP.CFG, FSR.kicad_sch, NPulse_v4.kicad_pcb, NPulse_v4.kicad_sch, TL3305BF100QG.step, TL3305BF100QG.stp, TXU0202DCUR.step]
2025-02-26 clean the repo a little bit
    [NPulse_v4.kicad_pcb, empreintes.xlsx]
2025-03-07 Udate mounting holes positions
    [NPulse_v4.kicad_pcb, NPulse_v4.kicad_sch, connecteur.kicad_pcb, connecteur.kicad_sch]
2025-03-09 Few corrections: tracks, via, thermal pad
    [NPulse_v4.kicad_pcb, motor_driver.kicad_sch]
2025-03-10 add 5v-gnd pair
    [NPulse_v4.kicad_pcb, connecteur.kicad_pcb, connecteur.kicad_sch]
2025-03-10 generate gerber files
    [NPulse_v4-B_Cu.gbr, NPulse_v4-B_Mask.gbr, NPulse_v4-B_Paste.gbr, NPulse_v4-B_Silkscreen.gbr, NPulse_v4-Edge_Cuts.gbr, NPulse_v4-F_Cu.gbr, NPulse_v4-F_Mask.gbr, NPulse_v4-F_Paste.gbr]
